markjuhrig/APIS/README.md

# APIS
Automatic Pilot Interaction System (APIS)

Alle notwendigen Informationen zum Aufbau des Systems finden sich in der PDF-Datei im Ordner Doc.

Hinweis: die beschriebene Änderung der Library für das MP3-Shield (siehe Seite 21) ist nur bei Verwendung eines Arduino Unos (R3) nötig. Alternativ kann ein Arduino Mega eingesetzt werden. Dieser hat mehr RAM-Speicher, was die Modifikation der MP3-Bibliothek unnötig macht.  
