markjuhrig/APIS/MP3/MP3-Files.xlsx

Date | Time | Size | File | Description
2021-04-02 | 09:33 | 10747 | 0.mp3
2021-03-27 | 20:37 | 13926 | 1.mp3
2021-03-29 | 20:10 | 13537 | 10.mp3
2021-03-29 | 20:10 | 13928 | 12.mp3
2021-03-29 | 20:11 | 14344 | 14.mp3
2021-03-29 | 20:12 | 17163 | 16.mp3
2021-03-29 | 20:12 | 16143 | 18.mp3
2021-03-27 | 20:37 | 10276 | 2.mp3
2021-03-29 | 20:13 | 12991 | 20.mp3
2021-03-29 | 20:14 | 14502 | 25.mp3
2021-03-27 | 20:38 | 11738 | 3.mp3
2021-03-29 | 20:15 | 14034 | 30.mp3
2021-03-29 | 20:16 | 15599 | 35.mp3
2021-03-27 | 20:38 | 12467 | 4.mp3
2021-03-29 | 20:16 | 12128 | 40.mp3
2021-03-29 | 20:17 | 13720 | 45.mp3
2021-03-27 | 20:38 | 12207 | 5.mp3
2021-03-29 | 20:17 | 12625 | 50.mp3
2021-03-27 | 20:39 | 16301 | 6.mp3
2021-03-27 | 20:39 | 12312 | 7.mp3
2021-03-27 | 20:40 | 11764 | 8.mp3
2021-03-27 | 20:40 | 11060 | 9.mp3
2021-03-29 | 20:20 | 8945 | aus.mp3
2021-03-27 | 20:37 | 11373 | ein.mp3
2021-04-05 | 08:04 | 91549 | ende.mp3
2021-03-27 | 20:24 | 87323 | ende0.mp3
2021-03-29 | 20:43 | 16382 | gaus.mp3
2021-03-24 | 19:43 | 9699 | grad.mp3
2021-03-31 | 16:30 | 21568 | info.mp3 | Michelstadt Info
2023-04-24 |  |  | radi.mp3 | Michelstadt Radio
2021-03-29 | 20:58 | 19561 | kaus.mp3
2021-04-05 | 08:05 | 61811 | kfz.mp3
2021-03-27 | 20:42 | 12103 | kts.mp3
2021-03-27 | 20:47 | 8606 | mit.mp3
2021-03-27 | 20:30 | 25090 | msgw.mp3
2021-03-27 | 20:32 | 20865 | n.mp3
2021-03-27 | 21:06 | 11060 | nem.mp3
2021-03-24 | 19:41 | 3433 | nix.mp3
2021-03-27 | 20:32 | 25224 | no.mp3
2021-03-27 | 20:35 | 25665 | nw.mp3
2021-03-27 | 20:33 | 21284 | o.mp3
2021-03-29 | 20:49 | 4512 | paus.mp3
2021-04-05 | 08:06 | 61815 | pb15.mp3
2021-04-05 | 08:06 | 65364 | pb30.mp3
2021-04-05 | 08:07 | 99582 | pba1.mp3
2021-04-05 | 08:07 | 79186 | pbas.mp3
2021-03-27 | 20:41 | 16172 | qnh.mp3
2021-04-05 | 08:04 | 43455 | rc.mp3
2021-03-27 | 20:33 | 19978 | s.mp3
2021-03-27 | 20:29 | 23681 | schw.mp3
2021-04-01 | 18:44 | 36984 | serr.mp3
2021-03-27 | 20:33 | 25354 | so.mp3
2021-03-27 | 20:28 | 18727 | still.mp3
2021-03-27 | 20:31 | 23575 | stkw.mp3
2021-03-27 | 20:35 | 24282 | sw.mp3
2021-03-27 | 20:35 | 22430 | w.mp3
2021-03-31 | 07:16 | 42510 | wakt.mp3
2021-03-31 | 07:17 | 31036 | wdok.mp3
2021-03-27 | 20:45 | 16431 | wind.mp3
2021-03-29 | 20:19 | 14215 | wndm.mp3
